sunmagnetics/ERSFQlib/Cells/mitll_jtl/Test_ERSFQ_JTL.cir

* Generated by Xic from cell TEST_ERSFQ_JTL

* Author: L. Schindler
* Version: 0.1
* Last modification date: 11 May 2018
* Last modification by: L. Schindler

* Copyright (c) 2018-2019 Lieze Schindler, Stellenbosch University

* Permission is hereby granted, free of charge, to any person obtaining a copy
* of this cell library and associated documentation files (the "Library"), to deal
* in the Library without restriction, including without limitation the rights
* to use, copy, modify, merge, publish, distribute, sublicense, and/or sell
* copies of the Library, and to permit persons to whom the Library is
* furnished to do so, subject to the following conditions:

* The above copyright notice and this permission notice shall be included in all
* copies or substantial portions of the Library.

* THE LIBRARY IS PROVIDED "AS IS", WITHOUT WARRANTY OF ANY KIND, EXPRESS OR
* IMPLIED, INCLUDING BUT NOT LIMITED TO THE WARRANTIES OF MERCHANTABILITY,
* FITNESS FOR A PARTICULAR PURPOSE AND NONINFRINGEMENT. IN NO EVENT SHALL THE
* AUTHORS OR COPYRIGHT HOLDERS BE LIABLE FOR ANY CLAIM, DAMAGES OR OTHER
* LIABILITY, WHETHER IN AN ACTION OF CONTRACT, TORT OR OTHERWISE, ARISING FROM,
* OUT OF OR IN CONNECTION WITH THE LIBRARY OR THE USE OR OTHER DEALINGS IN THE
* LIBRARY.

*For questions about the library, contact Lieze Schindler, 17528283@sun.ac.za

.tran 0.5p 1000p 0 0.25p UIC
.plot tran L2.x3#branch L5.x3#branch "v(10)/2O"
I0 0 4 pulse(0 600u 1p 2p 2p 1p 50p)
I1 0 5 pwl(0 0 5p 800u 10p 800u 20p 700u)
I2 0 9 pwl(0 0 100p 0 103p 600u 106p 0 130p 0 133p 600u 136p 0)
L0 5 1 10p
R0 10 0 2
X0 2 1 11 feedingJTL
X1 4 3 MITLL_DCSFQ
X2 3 2 MITLL_JTL
X3 7 6 1 ERSFQ_JTL
X4 9 8 MITLL_DCSFQ
X5 8 7 MITLL_JTL
X6 6 10 MITLL_JTL
.subckt MITLL_DCSFQ IN OUT
B0 3 4 15 jjmit area=2.25
B1 5 10 16 jjmit area=2.25
B2 6 12 17 jjmit area=2.5
I0 0 7 pwl(0 0 5p 275u)
I1 0 8 pwl(0 0 5p 175u)
L0 7 4 0.2p
L1 8 6 0.2p
L2 IN 9 1p
L3 9 3 0.6p
L4 4 5 1.1p
L5 5 6 4.5p
L6 6 OUT 2p
L7 9 0 3.9p
L8 14 4 1p
L9 10 0 0.2p
L10 11 0 1p
L11 12 0 0.2p
L12 13 0 1p
R0 5 11 3.048846408
R1 6 13 2.743961767
R2 3 14 3.048846408
.ends MITLL_DCSFQ
.subckt feedingJTL CLK BIAS CONNECT
B0 4 8 12 jjmit area=2.5
B1 CONNECT 10 13 jjmit area=2.5
B2 6 5 14 jjmit area=3.5
L0 7 0 1p
L1 8 0 0.2p
L2 9 0 1p
L3 10 0 0.2p
L4 4 CLK 2p
L5 5 4 2p
L6 CONNECT 5 2p
L7 11 5 1p
L8 BIAS 6 400p
R0 4 7 3.88
R1 CONNECT 9 3.88
R2 6 11 1.96
.ends feedingJTL
.subckt MITLL_JTL IN OUT
B0 3 7 11 jjmit area=2.5
B1 4 9 12 jjmit area=2.5
I0 0 5 pwl(0 0 5p 350u)
L0 5 6 1p
L1 IN 3 2p
L2 3 6 2p
L3 6 4 2p
L4 4 OUT 2p
L5 7 0 0.2p
L6 8 0 1p
L7 9 0 0.2p
L8 10 0 1p
R0 3 8 3.88
R1 4 10 3.88
.ends MITLL_JTL
.subckt ERSFQ_JTL IN OUT BIAS1
.include ERSFQ_JTL_models.inc
.param Bc0=1
.param Ic0=0.0001
.param IcRs=100u*6.859904418
.param B0Rs=IcRs/Ic0*Bc0
.param B0=3.5, B1=2.5, R0=B0Rs/B0, R1=B0Rs/B1
B0 4 5 13 jjmit area=B0
B1 6 9 14 jjmit area=B1
B2 7 11 15 jjmit area=B1
L0 BIAS1 4 400p
L1 8 5 1p
L2 IN 6 2p
L3 6 5 2p
L4 5 7 2p
L5 7 OUT 4.5p
L6 9 0 0.2p
L7 10 0 1p
L8 11 0 0.2p
L9 12 0 1p
R0 4 8 R0
R1 6 10 R1
R2 7 12 R1
.ends ERSFQ_JTL
.model jjmit jj(rtype=1, vg=2.8mV, cap=0.07pF, r0=160, rn=16, icrit=0.1mA)

* YBCO
.save @I0.X1[c]
.save @I1.X1[c]
.save @I0.X4[c]
.save @I1.X4[c]
.save @I0.X6[c]
.save @I0.X2[c]
.save @I0.X5[c]
.save @I0[c]
.save @I2[c]
.save @I1[c]
