sunmagnetics/ERSFQlib/Examples/ERSFQ_FULL_ADDER.cir

* Generated by Xic from cell ERSFQ_FULL_ADDER
.tran 1p 6000p 2000p 0.5p UIC
.plot tran L2.x29#branch L2.x39#branch L4.x4#branch L2.x75#branch "v(80)/2O" "v(99)/2O"
I0 0 120 pwl(0 0 4340p 0 4343p 600u 4346p 0 5550p 0 5553p 600u 5556p 0)
I1 0 69 pwl(0 0 10p 30000u 600p 30000u 800p 27218u)
I2 0 127 pwl(0 0 3200p 0 3203p 600u 3206p 0)
I3 0 131 pwl(0 0 4200p 0 4203p 600u 4206p 0 4350p 0 4353p 600u 4356p 0)
I4 0 144 pulse(0 600u 1p 2p 2p 1p 50p)
L0 69 22 10p
L1 22 23 10p
L2 3 4 10p
L3 6 34 10p
L4 23 26 10p
L5 31 32 10p
L6 32 33 10p
L7 4 6 10p
L8 34 35 10p
L9 35 36 10p
L10 36 40 10p
L11 40 37 10p
L12 37 38 10p
L13 26 27 10p
L14 28 29 10p
L15 38 39 10p
L16 1 2 10p
L17 27 28 10p
L18 33 1 10p
L19 2 3 10p
L20 29 30 10p
L21 30 31 10p
L22 47 48 10p
L23 49 50 10p
L24 44 45 10p
L25 46 47 10p
L26 48 49 10p
L27 41 42 10p
L28 43 44 10p
L29 45 46 10p
L30 50 51 10p
L31 51 52 10p
L32 52 53 10p
L33 39 41 10p
L34 42 43 10p
L35 55 56 10p
L36 54 55 10p
L37 56 57 10p
L38 57 58 10p
L39 63 64 10p
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
X0 117 5 1 116 2 3 4 ERSFQ_DFF
X1 8 6 118 9 ERSFQ_SPLIT
X2 118 7 MITLL_JTL
X3 120 119 MITLL_DCSFQ
X4 119 117 MITLL_JTL
X5 116 8 MITLL_JTL
X6 9 10 MITLL_JTL
X7 11 22 23 12 feedingJTL2
X8 12 26 27 28 29 15 feedingJTL4
X9 15 30 31 32 33 16 feedingJTL4
X10 16 1 2 3 4 13 feedingJTL4
X11 14 34 35 36 145 37 38 17 feedingJTL6
X12 13 6 14 feedingJTL
X13 13 6 14 feedingJTL
X14 17 39 18 feedingJTL
X15 121 42 43 44 45 46 47 19 feedingJTL6
X16 19 48 49 50 51 52 53 20 feedingJTL6
X17 18 41 121 feedingJTL
X18 20 54 21 feedingJTL
X19 21 55 56 57 58 59 146 24 feedingJTL6
X20 24 61 62 63 64 25 feedingJTL4
X21 25 65 66 67 68 147 feedingJTL4
X22 78 71 70 122 34 35 36 40 148 38 ERSFQ_XOR
X23 73 7 75 123 55 56 57 58 59 60 ERSFQ_XOR
X24 79 74 65 124 66 67 68 ERSFQ_DFF
X25 72 73 MITLL_JTL
X26 76 22 125 81 ERSFQ_SPLIT
X27 125 71 MITLL_JTL
X28 77 39 72 82 ERSFQ_SPLIT
X29 127 126 MITLL_DCSFQ
X30 126 76 MITLL_JTL
X31 122 77 MITLL_JTL
X32 124 80 MITLL_JTL
X33 81 83 MITLL_JTL
X34 123 79 MITLL_JTL
X35 82 84 MITLL_JTL
X36 83 86 30 128 31 32 33 ERSFQ_DFF
X37 87 23 129 88 ERSFQ_SPLIT
X38 129 78 MITLL_JTL
X39 131 130 MITLL_DCSFQ
X40 130 87 MITLL_JTL
X41 10 84 92 132 48 49 85 51 52 53 54 ERSFQ_AND2
X42 128 89 MITLL_JTL
X43 88 90 MITLL_JTL
X44 132 91 MITLL_JTL
X45 90 94 26 133 93 28 29 ERSFQ_DFF
X46 133 95 MITLL_JTL
X47 97 91 96 134 61 62 63 64 ERSFQ_OR2
X48 89 95 98 135 42 43 41 44 45 46 47 ERSFQ_AND2
X49 135 97 MITLL_JTL
X50 134 99 MITLL_JTL
X51 100 94 86 MITLL_SPLIT
X52 101 5 11 MITLL_SPLIT
X53 102 101 MITLL_JTL
X54 103 100 MITLL_JTL
X55 104 70 MITLL_JTL
X56 105 98 MITLL_JTL
X57 106 92 MITLL_JTL
X58 107 75 MITLL_JTL
X59 108 96 MITLL_JTL
X60 109 74 MITLL_JTL
X61 136 102 103 MITLL_SPLIT
X62 137 104 105 MITLL_SPLIT
X63 138 106 107 MITLL_SPLIT
X64 139 108 109 MITLL_SPLIT
X65 110 136 MITLL_JTL
X66 111 137 MITLL_JTL
X67 112 138 MITLL_JTL
X68 113 139 MITLL_JTL
X69 140 110 111 MITLL_SPLIT
X70 141 112 113 MITLL_SPLIT
X71 114 140 MITLL_JTL
X72 115 141 MITLL_JTL
X73 142 114 115 MITLL_SPLIT
X74 143 142 MITLL_JTL
X75 144 143 MITLL_DCSFQ
.subckt feedingJTL4 CLK BIAS1 BIAS2 BIAS3 BIAS4 CONNECT
X0 CLK BIAS1 BIAS2 7 feedingJTL2
X1 7 BIAS3 BIAS4 CONNECT feedingJTL2
.ends feedingJTL4
.subckt feedingJTL6 CLK BIAS1 BIAS2 BIAS3 BIAS4 BIAS5 BIAS6 CONNECT
X0 CLK BIAS1 BIAS2 9 feedingJTL2
X1 9 BIAS3 BIAS4 10 feedingJTL2
X2 10 BIAS5 BIAS6 CONNECT feedingJTL2
.ends feedingJTL6
.subckt ERSFQ_OR2 IN1 IN2 INCLK OUT BIAS1 BIAS2 BIAS3 BIAS4
.include ERSFQ_OR2_models.inc
.param Bc0=1
.param Ic0=0.0001
.param IcRs=100u*6.859904418
.param B0Rs=IcRs/Ic0*Bc0
.param B0=4.4, B1=1.1, B2=2, B3=1.2, B4=2.6, B5=2, B6=2, B7=2.5, B8=3.25, B9=3, B10=2, B11=2.5
.param R0=B0Rs/B0, R1=B0Rs/B1, R2=B0Rs/B2, R3=B0Rs/B3, R4=B0Rs/B4, R5=B0Rs/B5, R6=B0Rs/B6, R7=B0Rs/B7, R8=B0Rs/B8, R9=B0Rs/B9, R10=B0Rs/B10, R11=B0Rs/B11
B0 9 13 49 jjmit area=B0
B1 10 14 50 jjmit area=B1
B2 11 15 51 jjmit area=B2
B3 12 16 52 jjmit area=B3
B4 17 33 53 jjmit area=B4
B5 18 19 54 jjmit area=B5
B6 20 21 55 jjmit area=B6
B7 20 37 56 jjmit area=B7
B8 23 24 57 jjmit area=B8
B9 24 40 58 jjmit area=B9
B10 25 42 59 jjmit area=B10
B11 26 44 60 jjmit area=B11
B12 27 28 61 jjmit area=B6
B13 27 47 62 jjmit area=B7
L0 BIAS1 9 400p
L1 BIAS2 10 400p
L2 BIAS3 11 400p
L3 BIAS4 12 400p
L4 29 13 1p
L5 30 14 1p
L6 31 15 1p
L7 32 16 1p
L8 INCLK 17 2.5p
L9 17 15 3.13p
L10 15 18 1.43p
L11 33 0 0.2p
L12 34 0 1p
L13 35 19 1p
L14 36 21 1p
L15 IN2 20 3p
L16 21 22 1.9p
L17 37 0 0.2p
L18 38 0 1p
L19 39 24 1p
L20 22 13 0.6p
L21 13 23 2.1p
L22 24 14 0.4p
L23 14 19 7.362p
L24 19 25 2.27p
L25 25 16 3.2p
L26 16 26 1.1p
L27 26 OUT 3.291p
L28 46 28 1p
L29 IN1 27 3p
L30 28 22 1.9p
L31 40 0 0.2p
L32 41 0 1p
L33 42 0 0.2p
L34 43 0 1p
L35 44 0 0.2p
L36 45 0 1p
L37 47 0 0.2p
L38 48 0 1p
R0 9 29 R0
R1 10 30 R1
R2 11 31 R2
R3 12 32 R3
R4 17 34 R4
R5 18 35 R5
R6 20 36 R6
R7 20 38 R7
R8 23 39 R8
R9 24 41 R9
R10 25 43 R10
R11 26 45 R11
R12 27 46 R6
R13 27 48 R7
.ends ERSFQ_OR2
.subckt feedingJTL2 CLK BIAS1 BIAS2 CONNECT
X0 CLK BIAS1 5 feedingJTL
X1 5 BIAS2 CONNECT feedingJTL
.ends feedingJTL2
.subckt MITLL_DCSFQ IN OUT
B0 3 4 15 jjmit area=2.25
B1 5 10 16 jjmit area=2.25
B2 6 12 17 jjmit area=2.5
I0 0 7 pwl(0 0 5p 275u)
I1 0 8 pwl(0 0 5p 175u)
L0 7 4 0.2p
L1 8 6 0.2p
L2 IN 9 1p
L3 9 3 0.6p
L4 4 5 1.1p
L5 5 6 4.5p
L6 6 OUT 2p
L7 9 0 3.9p
L8 14 4 1p
L9 10 0 0.2p
L10 11 0 1p
L11 12 0 0.2p
L12 13 0 1p
R0 5 11 3.048846408
R1 6 13 2.743961767
R2 3 14 3.048846408
.ends MITLL_DCSFQ
.subckt ERSFQ_XOR IN1 IN2 INCLK OUT BIAS1 BIAS2 BIAS3 BIAS4 BIAS5 BIAS6
.param B0=2.25, B1=0.6, B4=1.8, B5=1.6, B6=1.69, B7=2.17, B8=1.69, B9=1.75, B10=2.5, B11=1.85, B13=1.63, B14=2.18
.include ERSFQ_XOR_models.inc
.param Bc0=1
.param Ic0=0.0001
.param IcRs=100u*6.859904418
.param B0Rs=IcRs/Ic0*Bc0
.param B0=2.25, B1=0.6, B4=1.8, B5=1.6, B7=2.17, B8=1.69, B9=1.75, B10=2.5, B11=1.85, B13=1.63, B14=2.18
.param R0=B0Rs/B0, R1=B0Rs/B1, R4=B0Rs/B4, R5=B0Rs/B5, R6=B0Rs/B6, R7=B0Rs/B7, R8=B0Rs/B8, R9=B0Rs/B9, R10=B0Rs/B10, R11=B0Rs/B11, R13=B0Rs/B13, R14=B0Rs/B14
B0 11 17 58 jjmit area=B0
B1 12 18 59 jjmit area=B1
B2 13 19 60 jjmit area=B0
B3 14 20 61 jjmit area=B1
B4 15 21 62 jjmit area=B4
B5 16 22 63 jjmit area=B5
B6 21 23 64 jjmit area=B6
B7 21 41 65 jjmit area=B7
B8 24 25 66 jjmit area=B8
B9 27 44 67 jjmit area=B9
B10 24 46 68 jjmit area=B10
B11 26 28 69 jjmit area=B11
B12 29 30 70 jjmit area=B8
B13 31 50 71 jjmit area=B13
B14 32 52 72 jjmit area=B14
B15 33 54 73 jjmit area=B9
B16 29 56 74 jjmit area=B10
L0 BIAS1 11 400p
L1 BIAS2 12 400p
L2 BIAS3 13 400p
L3 BIAS4 14 400p
L4 BIAS5 15 400p
L5 BIAS6 16 400p
L6 34 17 1p
L7 35 18 1p
L8 36 19 1p
L9 37 20 1p
L10 38 21 1p
L11 39 22 1p
L12 40 23 1p
L13 INCLK 21 2.436p
L14 43 25 1p
L15 41 0 0.2p
L16 42 0 1p
L17 IN2 27 2.53p
L18 27 19 1p
L19 19 24 2.1p
L20 25 20 1.6p
L21 20 26 1.9p
L22 44 0 0.2p
L23 45 0 1p
L24 46 0 0.2p
L25 47 0 1p
L26 23 31 3.07p
L27 48 28 1p
L28 49 30 1p
L29 28 31 1.422p
L30 31 22 4.047p
L31 22 32 1.047p
L32 32 OUT 2.213p
L33 IN1 33 2.53p
L34 33 17 1p
L35 17 29 2.1p
L36 30 18 1.6p
L37 18 26 1.9p
L38 50 0 0.2p
L39 51 0 1p
L40 52 0 0.2p
L41 53 0 1p
L42 54 0 0.2p
L43 55 0 1p
L44 56 0 0.2p
L45 57 0 1p
R0 11 34 R0
R1 12 35 R1
R2 13 36 R0
R3 14 37 R1
R4 15 38 R4
R5 16 39 R5
R6 21 40 R6
R7 21 42 R7
R8 24 43 R8
R9 27 45 R9
R10 24 47 R10
R11 26 48 R11
R12 29 49 R8
R13 31 51 R13
R14 32 53 R14
R15 33 55 R9
R16 29 57 R10
.ends ERSFQ_XOR
.subckt ERSFQ_DFF IIN ICLK BIAS1 OUT BIAS2 BIAS3 BIAS4
.param R0=B0Rs/B0
.param R1=B0Rs/B1
.param R2=B0Rs/B2
.param R3=B0Rs/B3
.param R4=B0Rs/B4
.include ERSFQ_DFF_models.inc
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
.save @I0.X42[c]
.save @I0.X27[c]
.save @I0.X57[c]
.save @I0.X59[c]
.save @I0.X74[c]
.save @I0.X3[c]
.save @I1.X3[c]
.save @I0.X29[c]
.save @I1.X29[c]
.save @I0.X39[c]
.save @I1.X39[c]
.save @I0.X75[c]
.save @I1.X75[c]
.save @I0[c]
.save @I1[c]
.save @I2[c]
.save @I3[c]
.save @I4[c]
