sunmagnetics/ERSFQlib/(commit log)

2018-05-09 Initial push
    Added current ERSFQ cell library along with individual test circuits
2018-05-11 Parameterized ERSFQ cells
    Implemented parameterization within the electrical schematic which can be altered by the used if needed
